rodrigo-brito/car-metrics/3d/explodido.stl

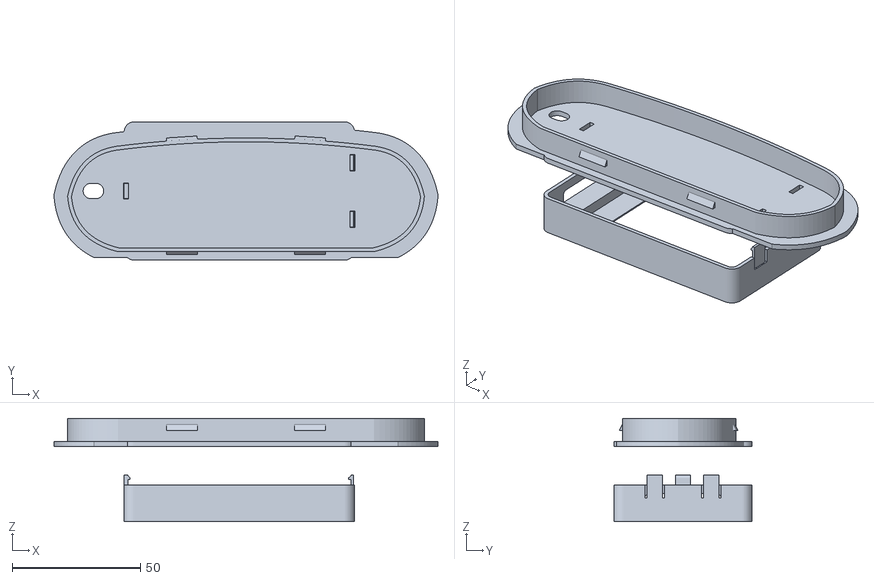
[picture p1: CAD file, 2026-10-30]
3d/explodido.stl
150.0 x 54.1 x 40.3
