rodrigo-brito/car-metrics/3d/montado.stl

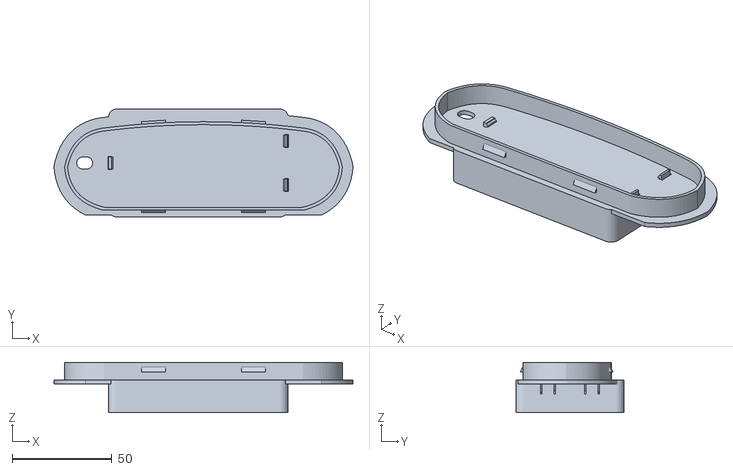
[picture p2: CAD file, 2026-10-30]
3d/montado.stl
150.0 x 54.1 x 25.3
