rodrigo-brito/car-metrics/3d/tampa_moldura.stl

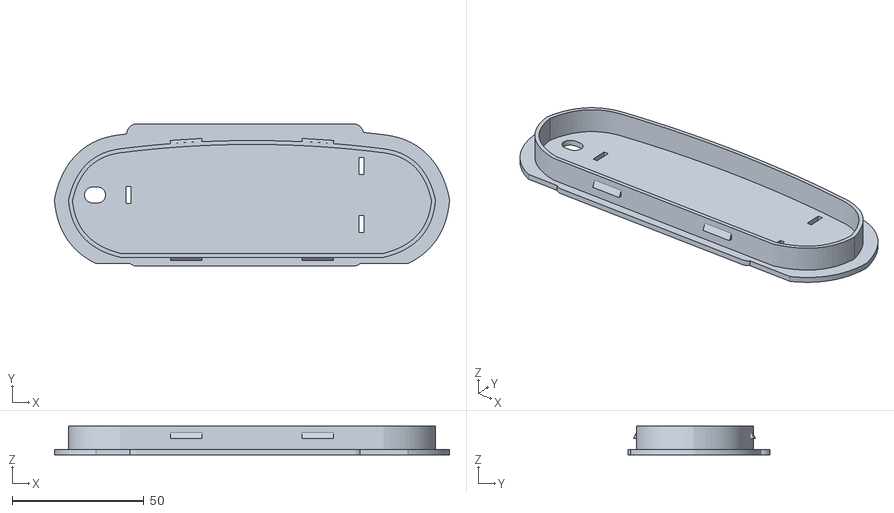
[picture p3: CAD file, 2026-10-30]
3d/tampa_moldura.stl
150.0 x 54.1 x 11.0
