rodrigo-brito/car-metrics/3d/case.stl

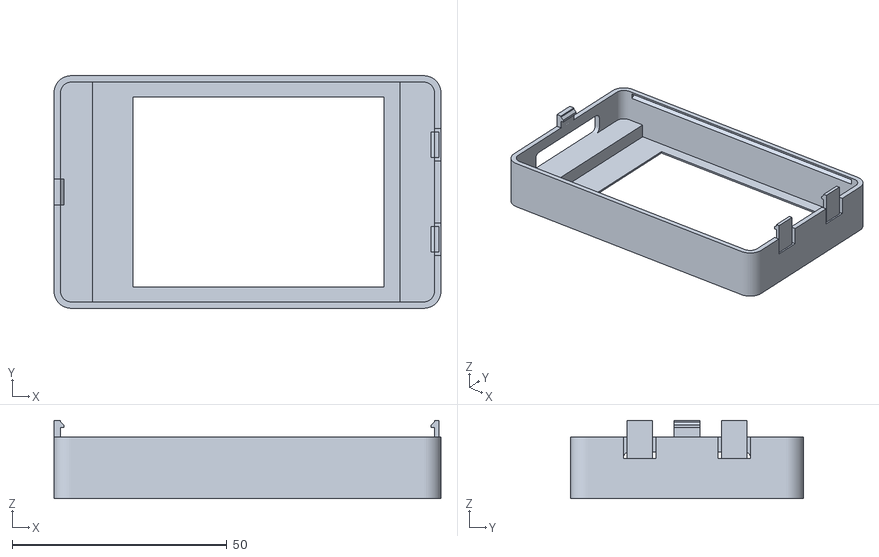
[picture p4: CAD file, 2026-10-30]
3d/case.stl
90.0 x 54.1 x 18.2
