rodrigo-brito/car-metrics/(commit log)

2026-10-29 Versão inicial do painel de status no ESP32-2432S028
    Conecta no Wi-Fi, consulta https://usestl.com/health a cada 30 s e mostra
    o resultado na tela ILI9341, numa página web servida pelo próprio ESP32,
    no monitor serial e no LED RGB. Toque na tela força consulta imediata.
    Build com arduino-cli; pinos do TFT_eSPI passados por flags no Makefile.
2026-10-29 Computador de bordo: mock, fonte ELM327 Bluetooth e interface dark mode
    Substitui o painel de status por um computador de bordo para o
    ESP32-2432S028. Camada ObdSource com simulação de condução e fonte
    ELM327 via Bluetooth clássico (KW902), interface com velocímetro,
    arco de rpm, cards de consumo/motor/tanque/bateria/média e rodapé
    da viagem. Toque alterna para página de diagnóstico.
    Varredura Bluetooth quando o adaptador não é encontrado, fallback
    para simulação, inversão de cores do painel, captura de tela via
    serial e partição huge_app. README com fluxo de conexão no carro,
    tabela de sintomas e pendências.
2026-10-30 Painel em três páginas, fonte BLE e leitura real da TR4
    O KONNWEI KW902 não pareia por Bluetooth clássico; a conexão passa a
    ser por BLE (NimBLE, serviço FFF0), validada no carro. Protocolo ELM327
    separado do transporte (obd_elm.h), com obd_ble.h e obd_bt.h.
    Interface em três páginas: dirigir, motor (trims, sondas, avanço,
    malha) e diagnóstico (luz de injeção, códigos de falha, apagar com
    toque longo, VIN). Alertas em tela cheia para motor quente, bateria
    baixa e luz de injeção. Consumo por speed-density quando não há MAF,
    configurado para a Pajero TR4 2.0. Espera pela ECU com ignição
    desligada. Scripts em tools/ para validar adaptador BLE e capturar
    a tela.
    Co-Authored-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
2026-10-30 Case 3D da tela para o painel da Pajero TR4
    Case do ESP32 CYD 2.8" e tampa traseira que funciona como moldura,
    com saia oval e garras que encaixam no furo do painel. Fonte em
    OpenSCAD (case_tela_28.scad) e STLs prontos para imprimir, mais
    vistas montada e explodida. LEIA-ME com medidas do furo, garras e
    passagem do cabo USB.
    [case.stl, case_tela_28.scad, explodido.stl, montado.stl, tampa_moldura.stl]
